NeXan87/Smart-Air-Freshener/README.md

# Smart Air Freshener - умный освежитель воздуха с глубоким сном, пробуждением по свету и кнопке

"Превращение" классического освежителя воздуха AirWick в умный на Arduino Pro Mini с энергосбережением и гибкой настройкой. Устройство работает в двух основных режимах — автоматическом и ручном:

- В автоматическом режиме, если свет в помещении включён не менее двух минут, устройство переходит в состояние готовности. Как только свет выключается (либо сразу, зависит от переключателя), происходит автоматический пшик.
- В ручном режиме пшик запускается по нажатию кнопки в любой момент, независимо от освещения. Количество пшиков (от одного до трёх) и выбор режима задаются физическими переключателями.

При снижении напряжения батареи до 3.4 В или ниже включается мигающий индикатор разряда. Когда свет выключен и нет активности, устройство уходит в глубокий сон с потреблением менее 1 мА.
После каждого пшика мотор автоматически выполняет короткий реверс, чтобы надёжно вернуть каретку в исходное положение и избежать залипания.
Желательно использовать цифровой датчик OPT3001, потому что делитель с фоторезистором потребляет большой ток — около 100мкА.

💾 Скачать [Руководство по эксплуатации](https://github.com/NeXan87/Smart-Air-Freshener/tree/main/Manual.docx?raw=true)!<br/>
📷 Открыть [галерею с фото](https://github.com/NeXan87/Smart-Air-Freshener/tree/main/Gallery)

## 📐 Схемы подключения

### Общая схема

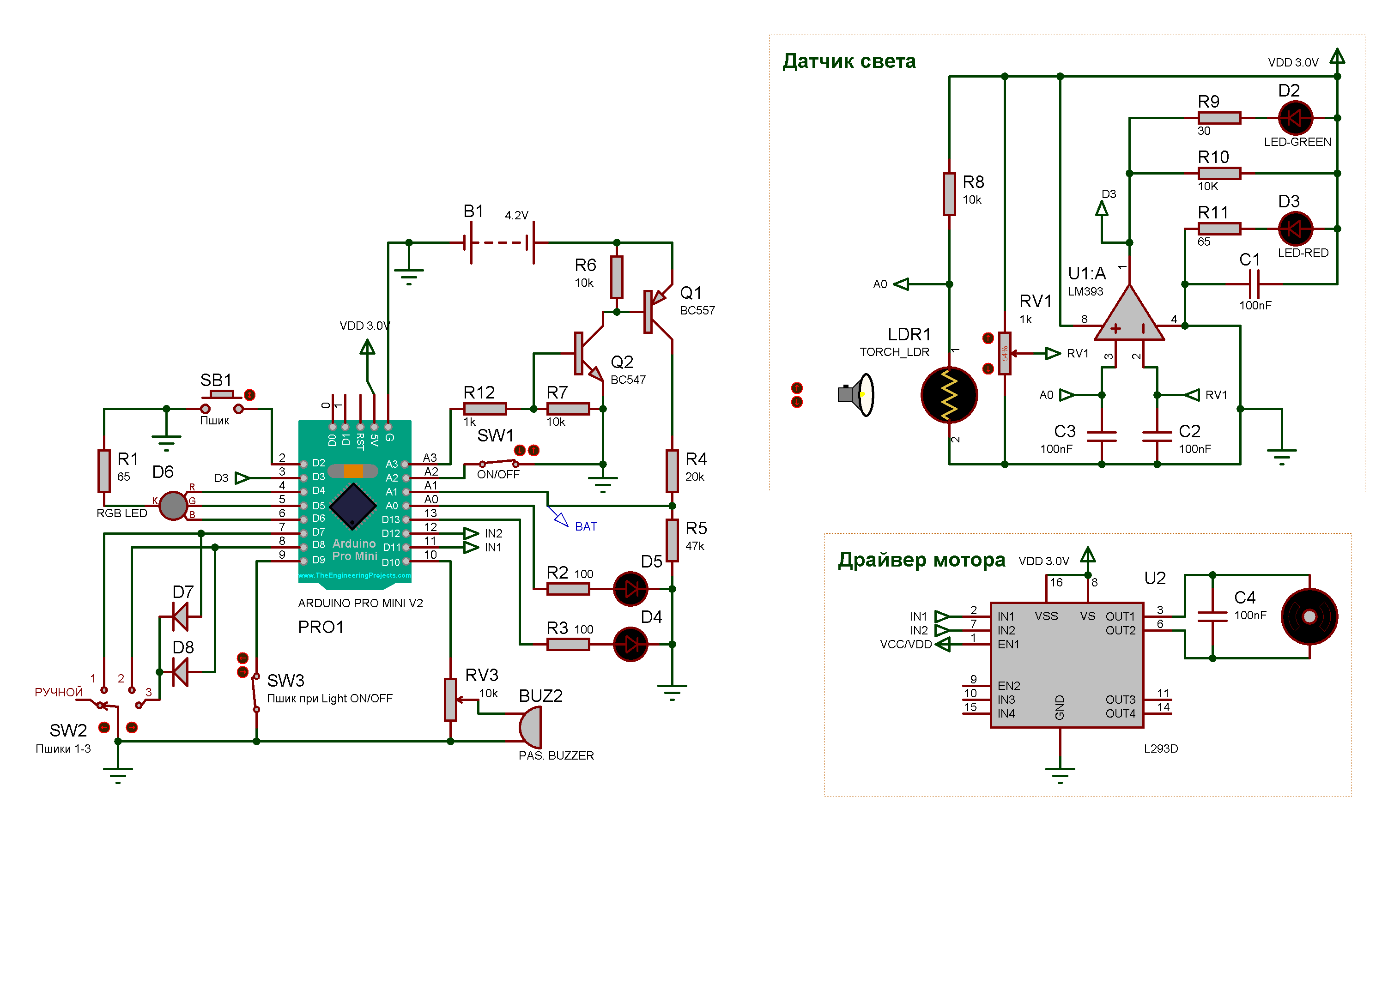
[picture p1: Electric Diagram/Smart-Air-Freshener.png]
Принципиальная схема умного освежителя воздуха на Arduino Pro Mini


### Драйвер двигателя MX1508

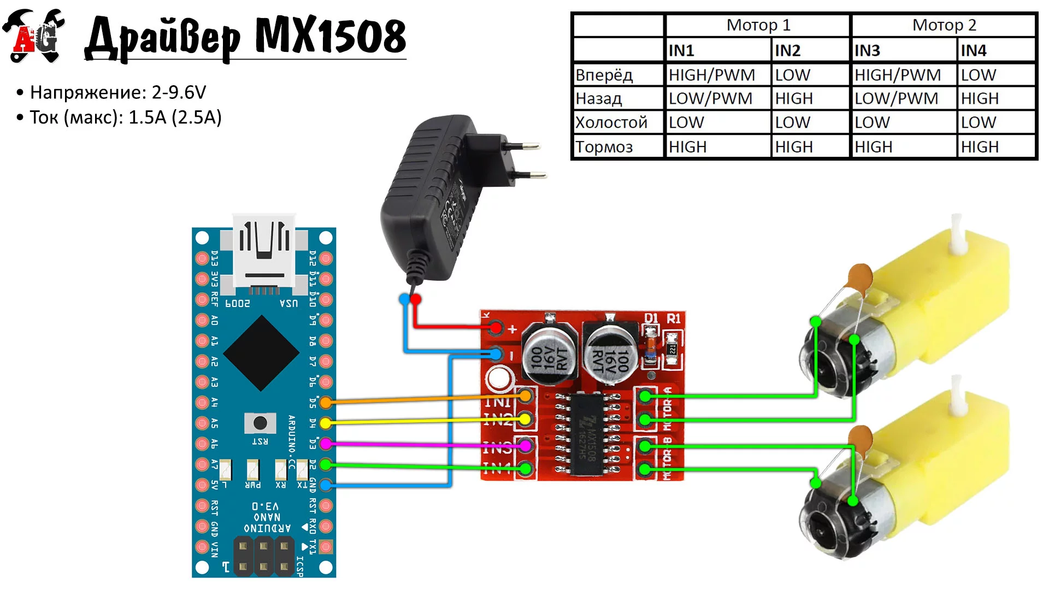
[picture p2: Electric Diagram/mx1508.png]
Схема подключения драйвера двигателя MX1508


### DC-DC преобразователь

Схема подключения DC-DC преобразователя

---

## ✨ Возможности

- **Автоматический пшик** через 2 минуты после выключения света или сразу
- **Ручной пшик** по кнопке — без блокировки после пшика
- **1/2/3 пшика** — в автоматическом режиме, выбор через переключатель
- **Режим "только ручной"** — игнорирует свет
- **Блокировка на 15 мин** после автоматического пшика (настраивается)
- **Сброс блокировки** — удержанием кнопки 2+ сек
- **Контроль батареи** (Li-ion 4.2 В): мигает доп. светодиод при ≤3.4 В
- **Полный сон** (0,7 мА) при выключенном свете и в состоянии покоя
- **Мотор с реверсом** — надёжный возврат каретки
- Поддержка **OPT3001** или **аналогового фоторезистора**

---

## 🔌 Аппаратура

- **МК**: Arduino Pro Mini 3.3V / 8 МГц (ATmega328P)
- **Питание**: Li-ion 4.2В (далее DC преобразователь на 3.0В)
- **Мотор**: родной DC-мотор через MX1508
- **Светодиоды**: RGB + встроенный + дополнительный
- **Пищалка**: пассивная
- **Переключатели**: кнопка + 4-позиционный режим + пара 2 позиционных
- **DC-DC преобразователь**:

1. Выходное напряжение: 3 В.
2. Выходной ток: 1 А (макс.) (рекомендуется длительная работа ниже 800 мА.).
3. Зарядный ток: 300 (макс.), можно настроить.
4. Напряжение защиты аккумулятора от чрезмерной разрядки: 3 В; полное напряжение: 4,2 В.
5. Индикатор зарядки: 4,2 В
6. Ток покоя: около 6 мкА
7. Размер: 18x9x2,3 мм.

---

## 🔋 Энергопотребление

- **Активный режим**: ~2.8 мА
- **Глубокий сон**: 0,7 мА (не получилось сделать меньше)
- **Пшик**: ~400 мА (кратковременно)

---

## ⚡ Советы по повышению энергосбережения

1. Отпаяйте от платы Arduino стабилизатор напряжения и светодиод питания.
2. Отключите фьюзы BOD через программатор (между прочим включенный BOD может приводить к перезагрузке во время пшика).
3. Выбирайте DC-DC преобразователь с наименьшим током покоя.
4. Используйте OPT3001 вместо фоторезистора, так как его ток покоя всего несколько мкА.
5. Отпаяйте резистор подтяжки на OPT3001 на пин INT и используйте INPUT_PULLUP.
6. Подбирайте резисторы для светодиодов так, чтобы они только начинали светиться при минимальном токе. У меня получилось 1 кОм.
7. Используйте AVR на 8 мГц и питание 3-3.3В (чем выше частота и напряжение, тем выше ток).

---

## 📋 Полный список констант и их описание

Все настройки находятся в файле [`config.h`](https://github.com/NeXan87/Auto-Spray/blob/refactor/Firmware/Smart-Air-Freshener/config.h). Ниже — подробное описание каждой константы.

### 🔌 ПИНЫ ПОДКЛЮЧЕНИЯ

| Константа | Значение | Описание |
| --- | --- | --- |
| `PIN_ADD_LED` | `A0` | Дополнительный светодиод (например, для индикации разряда) |
| `PIN_BATTERY_POINT` | `A1` | Аналоговый вход для измерения напряжения батареи (точка делителя) |
| `PIN_SW_GLOBAL_EN`  | `A2` | Цифровой выключатель всего устройства (LOW = выключено) |
| `PIN_BUTTON` | `2` | Кнопка ручного распыления (активный уровень: GND) |
| `PIN_LIGHT` | `3` | Датчик света: `HIGH` = свет включён, `LOW` = выключен |
| `PIN_LED_R` | `4` | Красный светодиод RGB-модуля |
| `PIN_LED_G` | `5` | Зелёный светодиод RGB-модуля |
| `PIN_LED_B` | `6` | Синий светодиод RGB-модуля |
| `PIN_SW_SPRAY_1` | `7` | Переключатель: замыкание на GND = 1 пшик |
| `PIN_SW_SPRAY_2` | `8` | Переключатель: замыкание на GND = 2 пшика; оба замкнуты = 3 пшика |
| `PIN_SW_MODE` | `9` | Переключатель режима: `LOW` = автоматический пшик после выключения света |
| `PIN_BUZZER` | `10` | Пассивная пищалка (управляется через `tone()`) |
| `PIN_MOTOR_IN1` | `11` | Вход IN1 драйвера MX1508 (управление направлением) |
| `PIN_MOTOR_IN2` | `12` | Вход IN2 драйвера MX1508 (управление направлением) |
| `PIN_LED_BUILTIN` | `13` | Встроенный светодиод на плате (для отладки/активности) |

### 🔋 КОНТРОЛЬ НАПРЯЖЕНИЯ БАТАРЕИ (Li-ion, 4.2 В)

| Константа | Значение  | Описание |
| --- | --- | --- |
| `VCC_ARDUINO` | `3000.0f` | Опорное напряжение Arduino (мВ), используется для расчёта реального напряжения |
| `BATTERY_DIVIDER_RATIO` | `1.43f` | Коэффициент делителя: `(R1 + R2) / R2` (например, R1=4.7к, R2=10к → 1.47) |
| `BATTERY_LOW_MV` | `3400` | Порог "низкого заряда" (мВ); при ≤3.4 В — мигает индикатор |
| `BATTERY_BLOCKED_MV` | `3200` | Порог глубокого разряда; при ≤3.2 В — полная блокировка работы |
| `BATTERY_CHECK_INTERVAL_MS` | `5000` | Интервал проверки напряжения (мс) |
| `BATTERY_LED_ON_MS` | `100` | Длительность вспышки индикатора разряда (мс) |
| `BATTERY_LED_OFF_MS` | `500` | Пауза между вспышками (мс) |

### ⏱️ ТАЙМИНГИ РАБОТЫ

| Константа | Значение | Описание |
| --- | --- | --- |
| `LIGHT_READY_MINUTES` | `2` | Время ожидания света до готовности (мин) |
| `BLOCK_MINUTES` | `15` | Время блокировки после пшика (мин) |
| `LIGHT_READY_MS` | `LIGHT_READY_MINUTES * 60 * 1000` | Время, в течение которого свет должен быть включён, чтобы перейти в режим `READY`, по умолчанию 2 мин. (мс) |
| `BLOCK_MS` | `BLOCK_MINUTES * 60 * 1000` | Время блокировки после автоматического распыления, по умолчанию 15 мин. (мс) |
| `LIGHT_READ_INTERVAL_MS` | `1000` | Интервал опроса датчика света (мс) — снижает энергопотребление |

### ⚙️ ПАРАМЕТРЫ РАСПЫЛЕНИЯ

| Константа | Значение | Описание |
| --- | --- | --- |
| `SPRAY_REVERSE_EN` | `false`  | Включить или выключить реверс |
| `SPRAY_ON_MS` | `500` | Длительность вращения мотора "вперёд" для пшика (мс) |
| `SPRAY_PAUSE1_MS`  | `300` | Пауза между "вперёд" и "реверсом" (мс) |
| `SPRAY_REVERSE_MS` | `200` | Длительность реверса (мс) — для возврата каретки |
| `SPRAY_PAUSE2_MS`  | `1000` | Пауза между повторными пшиками (если их >1) (мс) |

### 💡 ИНДИКАЦИЯ RGB-СВЕТОДИОДОМ

| Константа | Значение | Описание |
| --- | --- | --- |
| `LED_COMMON_ANODE` | `false`  | Тип RGB-модуля: `false` = общий катод, `true` = общий анод |
| `STARTUP_DELAY_MS` | `200` | Длительность свечения каждого цвета при старте (мс) |
| `LED_BLINK_ON_CONFIRM_MODE_MS`  | `100` | Время включения светодиода при подтверждении режима (мс) |
| `LED_BLINK_OFF_CONFIRM_MODE_MS` | `1000` | Время выключения светодиода при подтверждении режима (мс)  |

### 💡 ДОПОЛНИТЕЛЬНЫЙ СВЕТОДИОД (A0)

| Константа | Значение | Описание |
| --- | --- | --- |
| `BLINK_ON_CONFIRM_MODE_MS`  | `100` | Длительность вспышки при смене количества пшиков  |
| `BLINK_OFF_CONFIRM_MODE_MS` | `200` | Пауза между вспышками при смене количества пшиков |

### 💡 ВСТРОЕННЫЙ СВЕТОДИОД (D13) — ТОЛЬКО ДЛЯ ОТЛАДКИ

| Константа | Значение | Описание |
| --- | --- | --- |
| `ACTIVITY_LED_ENABLED` | `true` | Включить мигание D13 для подтверждения активности |
| `ACTIVITY_LED_ON_MS` | `100` | Длительность вспышки |
| `ACTIVITY_LED_OFF_MS`  | `2100` | Период: 100 мс вкл + 2000 мс выкл |

### 😴 УПРАВЛЕНИЕ СНОМ

| Константа | Значение | Описание |
| --- | --- | --- |
| `ENABLE_SLEEP_MODE` | `true` | Включить энергосберегающий режим (`true` = да, `false` = отладка) |

### 🔄 СБРОС БЛОКИРОВКИ

| Константа | Значение | Описание |
| --- | --- | --- |
| `BLOCK_RESET_HOLD_MS` | `2000` | Время удержания кнопки для сброса блокировки (мс) |
| `RESET_BEEP_DURATION_MS` | `200` | Длительность писка при успешном сбросе (мс) |

### 🔊 ПИЩАЛКА

| Константа | Значение | Описание |
| --- | --- | --- |
| `FREQ_SQUEAKER` | `1000` | Частота звука (Гц) |
| `READY_BEEP_MS` | `300` | Длительность сигнала при переходе в состояние `READY` (мс) |

### 🌞 ДАТЧИК ОСВЕЩЁННОСТИ OPT3001 (I²C)

| Константа | Значение | Описание |
| --- | --- | --- |
| `USE_OPT3001` | `true` | Использовать OPT3001 вместо аналогового фоторезистора |
| `OPT3001_I2C_ADDRESS` | `0x44` | Адрес на шине I²C (стандартный) |
| `OPT3001_LIGHT_THRESHOLD` | `100` | Порог срабатывания (в люксах): свет > 100 = включён |
| `OPT3001_HYSTERESIS` | `20` | Гистерезис (в люксах): предотвращает дребезг при пограничном свете |

### 📦 ТИПЫ ДАННЫХ (ENUM’Ы)

#### `State` — состояния устройства

- `STATE_IDLE` — исходное состояние
- `STATE_LIGHT_WAIT` — ожидание 2+ минут включённого света
- `STATE_READY` — готовность: свет выключен → пшик
- `STATE_SPRAY` — происходит распыление
- `STATE_BLOCKED` — блокировка после пшика
- `STATE_RESET_BEEP` — сигнал подтверждения сброса

#### `LedColor` — цвета RGB-светодиода

- `LED_RED_ON` / `LED_RED_OFF`
- `LED_GREEN_ON` / `LED_GREEN_OFF`
- `LED_BLUE_ON` / `LED_BLUE_OFF`

#### `SprayStep` — этапы распыления

- `FORWARD` — вращение вперёд
- `PAUSE1` — пауза перед реверсом
- `REVERSE` — реверс (возврат каретки)
- `PAUSE2` — пауза перед следующим пшиком
- `REPEAT` — повтор цикла (если пшиков >1)

---

## 🛠️ Прошивка

1. Установите библиотеки:
   - `Bounce2`
   - `GyverPower`
2. Выберите в IDE:
   - **Плата**: _Arduino Pro Mini_
   - **Процессор**: _ATmega328P (3.3V, 8 MHz)_
3. Настройте необходимые константы под себя.
4. Отключите двигатель (во время прошивки начинает работать)
5. Подключите программатор.
6. Загрузите прошивку.

---

## 📂 Структура

```
├── Smart-Air-Freshener.ino // точка входа
├── config.h // ВСЕ настройки здесь
├── state.cpp // машина состояний
├── leds.cpp // управление светодиодами
├── opt3001.cpp // конфигурация датчика света
├── spray.cpp // управление мотором
├── battery.cpp // контроль напряжения
├── sleep.cpp // управление сном
├── utils.cpp // общие функции
```

---

## 📝 Лицензия

Этот проект распространяется под лицензией MIT. Подробности см. в файле LICENSE .
