NeXan87/Smart-Air-Freshener/Gallery/2025-12-25 22-36-53.JPG

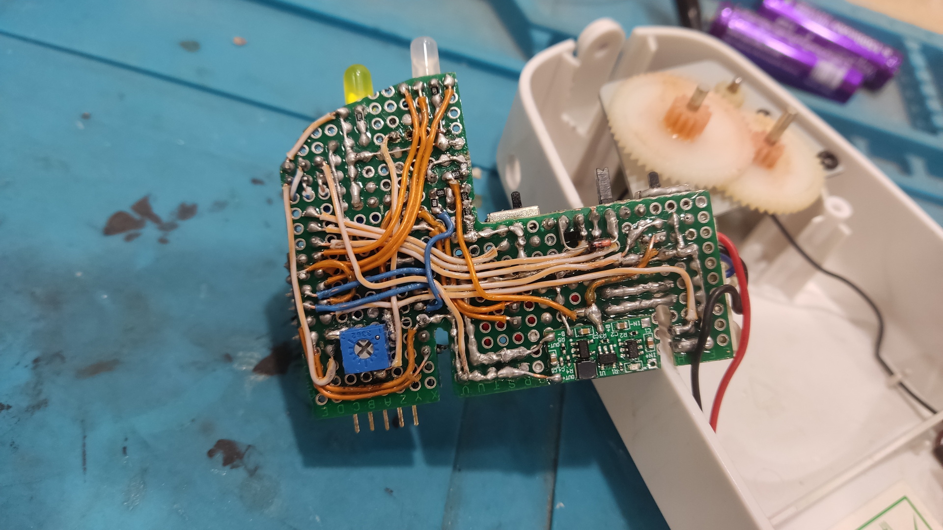
Gallery/2025-12-25 22-36-53.JPG
