NeXan87/Smart-Air-Freshener/Gallery/2025-12-25 22-38-05.JPG

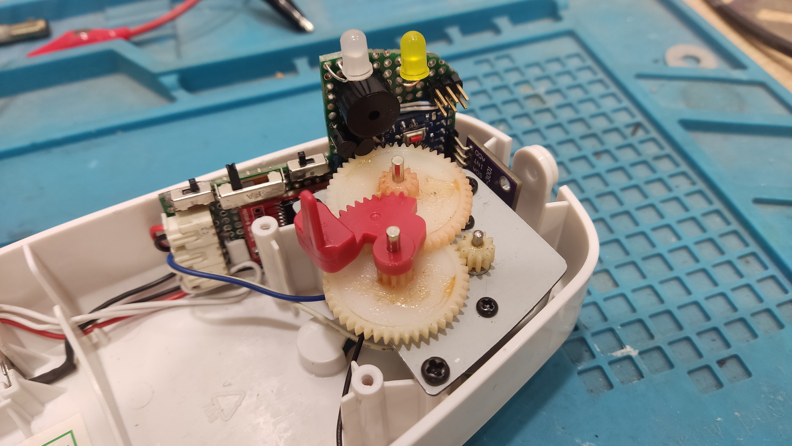
Gallery/2025-12-25 22-38-05.JPG
