NeXan87/Smart-Air-Freshener/Gallery/2025-12-25 22-59-06.JPG

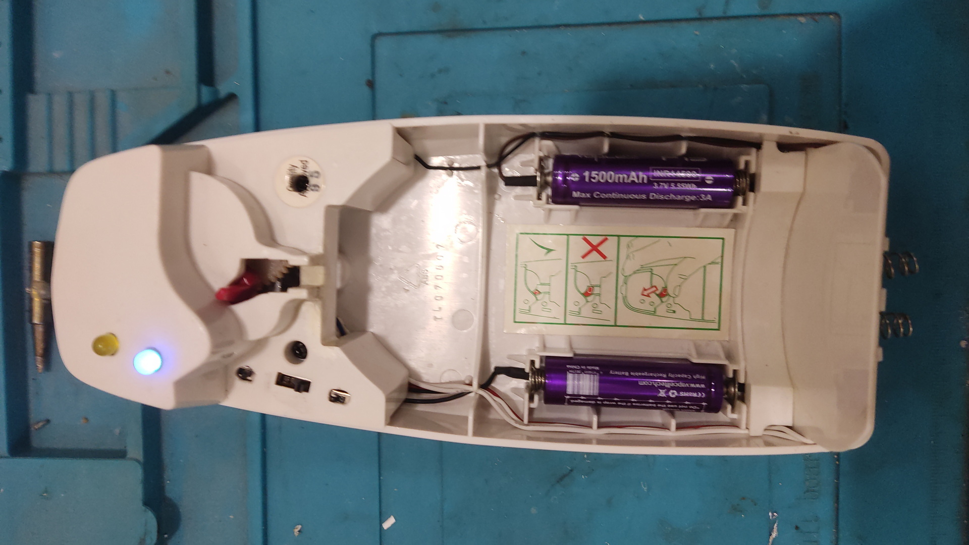
Gallery/2025-12-25 22-59-06.JPG
