NeXan87/Smart-Air-Freshener/Gallery/2025-12-25 23-02-40.JPG

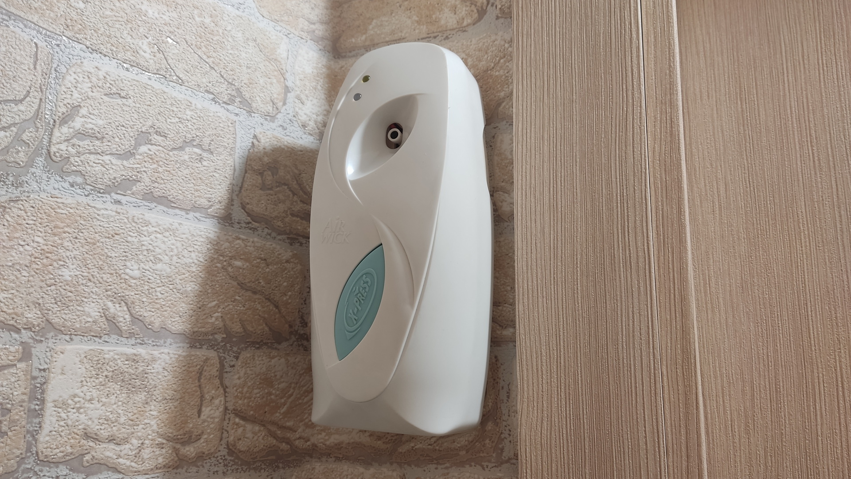
Gallery/2025-12-25 23-02-40.JPG
