NeXan87/Smart-Air-Freshener/(list of files, drawings)

Other design files:
Electric Diagram/Auto-Spray.pdsprj
Electric Diagram/Project Backups/Auto-Spray [20251121, 22-57-35].pdsprj
Electric Diagram/Project Backups/Auto-Spray [20251121, 23-06-02].pdsprj
Electric Diagram/Project Backups/Auto-Spray [20251121, 23-19-29].pdsprj
Electric Diagram/Project Backups/Auto-Spray [20251121, 23-27-33].pdsprj
Electric Diagram/Project Backups/Auto-Spray [20251122, 02-01-43].pdsprj
Electric Diagram/Proteus Library/Arduino Pro Mini Library for Proteus V2.0/Arduino Pro Mini Library for Proteus V2.0.DSN
Electric Diagram/Smart-Air-Freshener.pdsprj
