NeXan87/Smart-Air-Freshener/(commit log)

2025-11-19 Добавляет бета-версию проекта
2025-11-19 Обновляет README
2025-11-19 Начинает рефакторинг
2025-11-19 Добавляет библиотеку Bounce2
2025-11-21 Добавляет эл. схему
    [Arduino Pro Mini Library for Proteus V2.0.DSN, Auto-Spray [20251121, 22-57-35].pdsprj, Auto-Spray [20251121, 23-06-02].pdsprj, Auto-Spray.pdsprj]
2025-11-21 Рефакторит код
    [Auto-Spray [20251121, 23-19-29].pdsprj, Auto-Spray [20251121, 23-27-33].pdsprj, Auto-Spray [20251122, 02-01-43].pdsprj, Auto-Spray.pdsprj]
2025-11-22 Разделяет код на файлы
2025-11-22 Добавляет режим сна
2025-11-22 Добавляет сигнал снятия блокировки
2025-11-23 Удаляет лишний файл
2025-11-23 Добавляет фоторезистор
    [Auto-Spray.pdsprj]
2025-11-23 Добавляет драйвер двигателя
2025-11-23 Обновляет эл. схему
    [Auto-Spray.pdsprj]
2025-11-24 Исправляет баги
    [Auto-Spray.pdsprj]
2025-11-25 Исправляет баг с отсутствием блокировки после пшика
    [Auto-Spray.pdsprj]
2025-11-25 Добавляет опрос датчика света раз в секунду
2025-11-28 Меняет источник напряжения на АКБ
    [Auto-Spray.pdsprj]
2025-11-28 Устраняет баг с нерабочей кнопкой при выключенном свете
2025-11-28 Устраняет баг c бесконечными пшиками
2025-11-28 Добавляет индикацию активности
    [Auto-Spray.pdsprj]
2025-11-29 Удаляет временный файл
2025-12-03 Добавляет датчик OPT3001
2025-12-03 Добоавляет сброс состояния, если не нужно пшикать
    [Auto-Spray.pdsprj]
2025-12-04 Переопределяет пины
    [Auto-Spray.pdsprj]
2025-12-04 Подключает библиотеку GyverPower
2025-12-04 Меняет местами константы
2025-12-04 Редактирует режим сна
2025-12-06 Исправляет типизацию opt3001
2025-12-06 Переводит состояние пшика на millis
    [Auto-Spray.pdsprj]
2025-12-07 Переносит переключатель с D7 на A0
    [Auto-Spray.pdsprj]
2025-12-08 Добавляет подтверждение светодиодом при переключении кол. пшиков
    [Auto-Spray.pdsprj]
2025-12-08 Освобождает D9 и переносит на него пищалку
    [Auto-Spray.pdsprj]
2025-12-08 Меняет алгоритм автоматического режима
    [Auto-Spray.pdsprj]
2025-12-08 Отключает блокировку после нажатия кнопки
2025-12-08 Обновляет алгоритмы
    [Auto-Spray.pdsprj]
2025-12-08 Исправляет некоторые баги
2025-12-10 Меняет диод с общим катодом
    [Auto-Spray.pdsprj]
2025-12-12 Обновляет сравнения
2025-12-12 Переносит ENUM
2025-12-14 Добавляет переключатель включения устройства
    [Auto-Spray.pdsprj]
2025-12-14 Делает небольшие исправления
2025-12-15 Корректирует режим сна
2025-12-15 Делает небольшие улучшения
    [Auto-Spray.pdsprj]
2025-12-16 Улучшает код контроля батареи
2025-12-17 Делает наладку
    [Smart-Air-Freshener.pdsprj]
2025-12-18 Отключает пины во время сна
2025-12-18 Делает возиожность включения и отключения ADC
2025-12-18 Отключает PWR_TIMER1
2025-12-18 Добавляет ключ для отключения делителя
    [Smart-Air-Freshener.pdsprj]
2025-12-18 Исправляет сон при разряженной батареи
    [config.h, sleep.cpp]
2025-12-25 Добавляет галерею
